wallaceowen/FilaScaleBoard/filacase.kicad_pcb

## KiCad design filacase.kicad_pcb (2021-09-25)

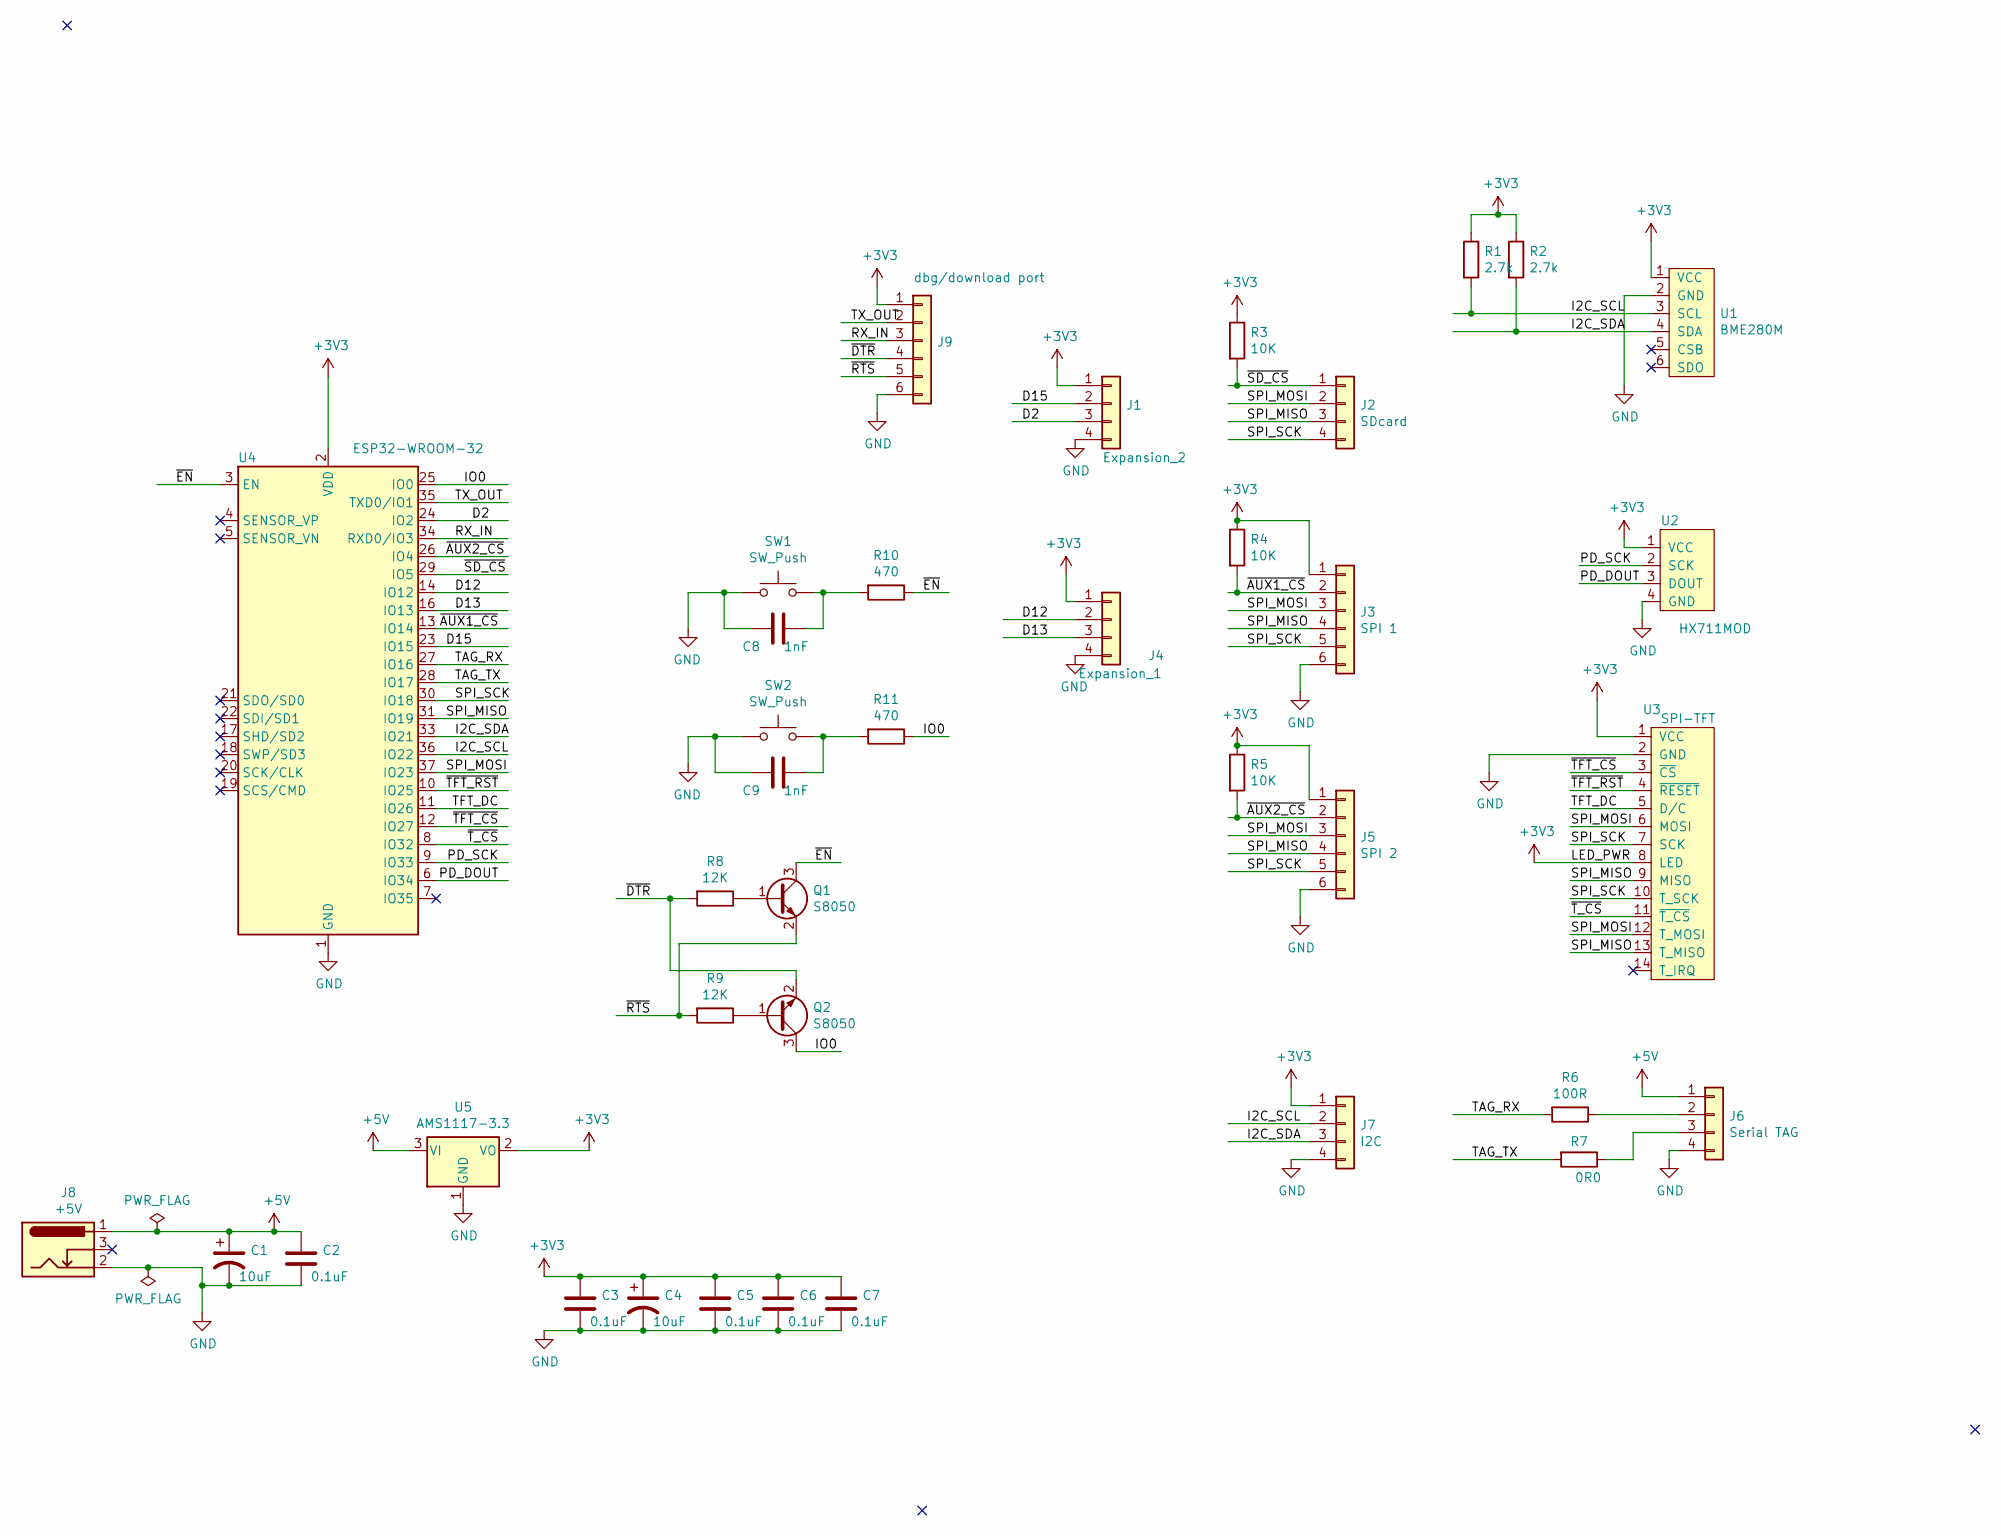
[picture p2: schematic filacase.sch]

Parts:
C1, C4: 10uF; C_2220_5650Metric_Pad1.97x5.40mm_HandSolder
C2, C3, C5, C6, C7: 0.1uF; C_0805_2012Metric
C8, C9: 1nF; C_0805_2012Metric
J1: Expansion_2; PinHeader_1x04_P2.54mm_Vertical
J2: SDcard; PinSocket_1x04_P2.54mm_Vertical
J3: SPI 1; PinHeader_1x06_P2.54mm_Vertical
J4: Expansion_1; PinHeader_1x04_P2.54mm_Vertical
J5: SPI 2; PinHeader_1x06_P2.54mm_Vertical
J6: Serial TAG; PinHeader_1x04_P2.54mm_Vertical
J7: I2C; PinHeader_1x04_P2.54mm_Vertical
J8: +5V; BarrelJack_Horizontal
J9: dbg/download port; PinHeader_1x06_P2.54mm_Vertical
Q1, Q2: S8050; SOT-23
R1, R2: 2.7k; R_0603_1608Metric
R3, R4, R5: 10K; R_0805_2012Metric
R6: 100R; R_0603_1608Metric
R7: 0R0; R_0603_1608Metric
R8, R9: 12K; R_0603_1608Metric
R10, R11: 470; R_0805_2012Metric
SW1, SW2: SW_Push; SW_Push_1P1T_NO_CK_KSC6xxJ
U1: BME280M; PinHeader_1x06_P2.54mm_Vertical
U2: HX711MOD; PinHeader_1x04_P2.54mm_Vertical
U3: SPI-TFT; PinSocket_1x14_P2.54mm_Vertical
U4: ESP32-WROOM-32
U5: AMS1117-3.3; SOT-223-3_TabPin2

Connections:
+3V3: C3.1, C4.1, C5.1, C6.1, C7.1, J1.1, J3.1, J4.1, J5.1, J7.1, J9.1, R1.1, R2.1, R3.1, R4.1, R5.1, U1.1 (VCC), U2.1 (VCC), U3.1 (VCC), U3.8 (LED), U4.2 (VDD), U5.2 (VO)
+5V: C1.1, C2.1, J6.1, J8.1, U5.3 (VI)
/D2: J1.3, U4.24 (IO2)
/D12: J4.2, U4.14 (IO12)
/D13: J4.3, U4.16 (IO13)
/D15: J1.2, U4.23 (IO15)
/I2C_SCL: J7.2, R1.2, U1.3 (SCL), U4.36 (IO22)
/I2C_SDA: J7.3, R2.2, U1.4 (SDA), U4.33 (IO21)
/IO0: Q2.3 (C), R11.1, U4.25 (IO0)
/PD_DOUT: U2.3 (DOUT), U4.6 (IO34)
/PD_SCK: U2.2 (SCK), U4.9 (IO33)
/RX_IN: J9.3, U4.34 (RXD0/IO3)
/SPI_MISO: J2.3, J3.4, J5.4, U3.9 (MISO), U3.13 (T_MISO), U4.31 (IO19)
/SPI_MOSI: J2.2, J3.3, J5.3, U3.6 (MOSI), U3.12 (T_MOSI), U4.37 (IO23)
/SPI_SCK: J2.4, J3.5, J5.5, U3.7 (SCK), U3.10 (T_SCK), U4.30 (IO18)
/TAG_RX: R6.2, U4.27 (IO16)
/TAG_TX: R7.2, U4.28 (IO17)
/TFT_DC: U3.5 (D/C), U4.11 (IO26)
/TX_OUT: J9.2, U4.35 (TXD0/IO1)
/~AUX1_CS~: J3.2, R4.2, U4.13 (IO14)
/~AUX2_CS~: J5.2, R5.2, U4.26 (IO4)
/~DTR~: J9.4, Q2.2 (E), R8.2
/~EN~: Q1.3 (C), R10.1, U4.3 (EN)
/~RTS~: J9.5, Q1.2 (E), R9.2
/~SD_CS~: J2.1, R3.2, U4.29 (IO5)
/~TFT_CS~: U3.3 (~CS~), U4.12 (IO27)
/~TFT_RST~: U3.4 (~RESET~), U4.10 (IO25)
/~T_CS~: U3.11 (~T_CS~), U4.8 (IO32)
GND: C1.2, C2.2, C3.2, C4.2, C5.2, C6.2, C7.2, C8.2, C9.2, J1.4, J3.6, J4.4, J5.6, J6.4, J7.4, J8.2, J9.6, SW1.1, SW2.1, U1.2 (GND), U2.4 (GND), U3.2 (GND), U4.1 (GND), U4.15 (GND), U4.38 (GND), U4.39 (GND), U5.1 (GND); also elsewhere on the board
unnamed: C8.1, R10.2, SW1.2
unnamed: C9.1, R11.2, SW2.2
unnamed: J6.2, R6.1
unnamed: J6.3, R7.1
unnamed: Q1.1 (B), R8.1
unnamed: Q2.1 (B), R9.1

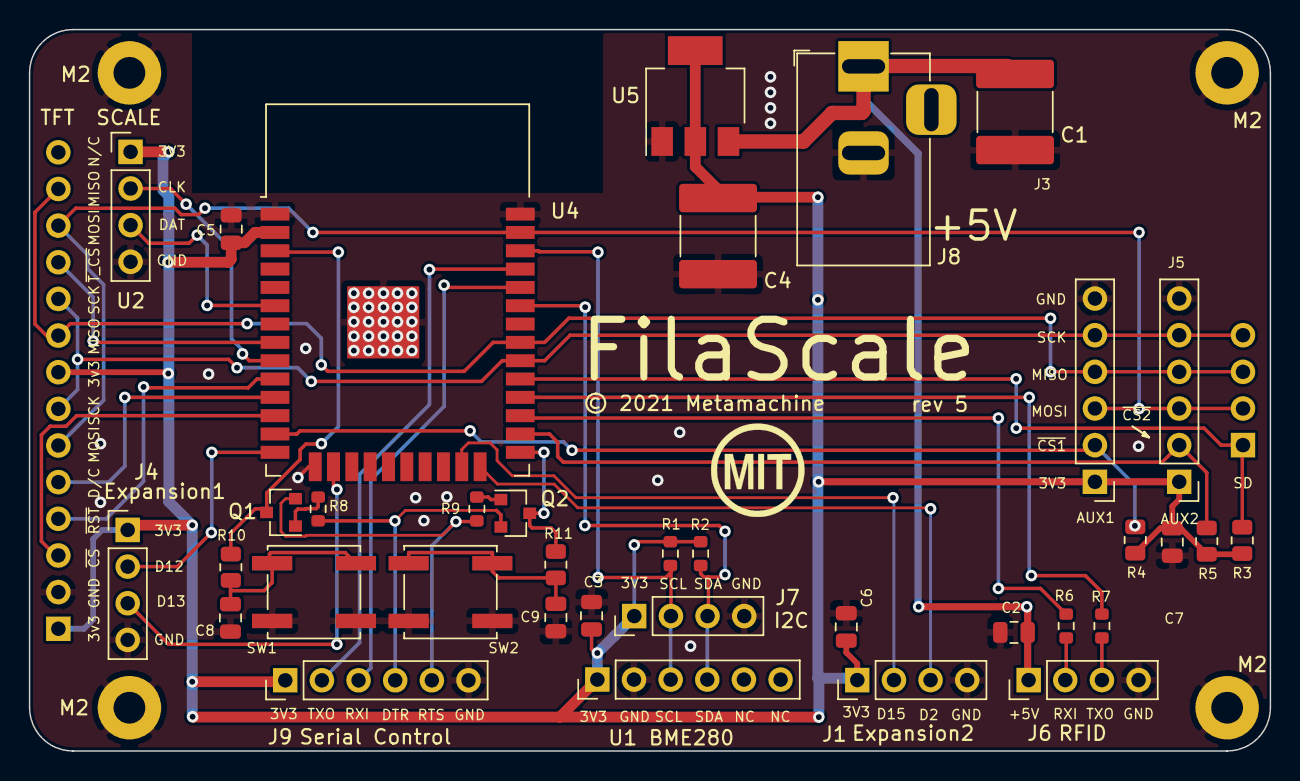
[picture p3: board filacase.kicad_pcb from above]

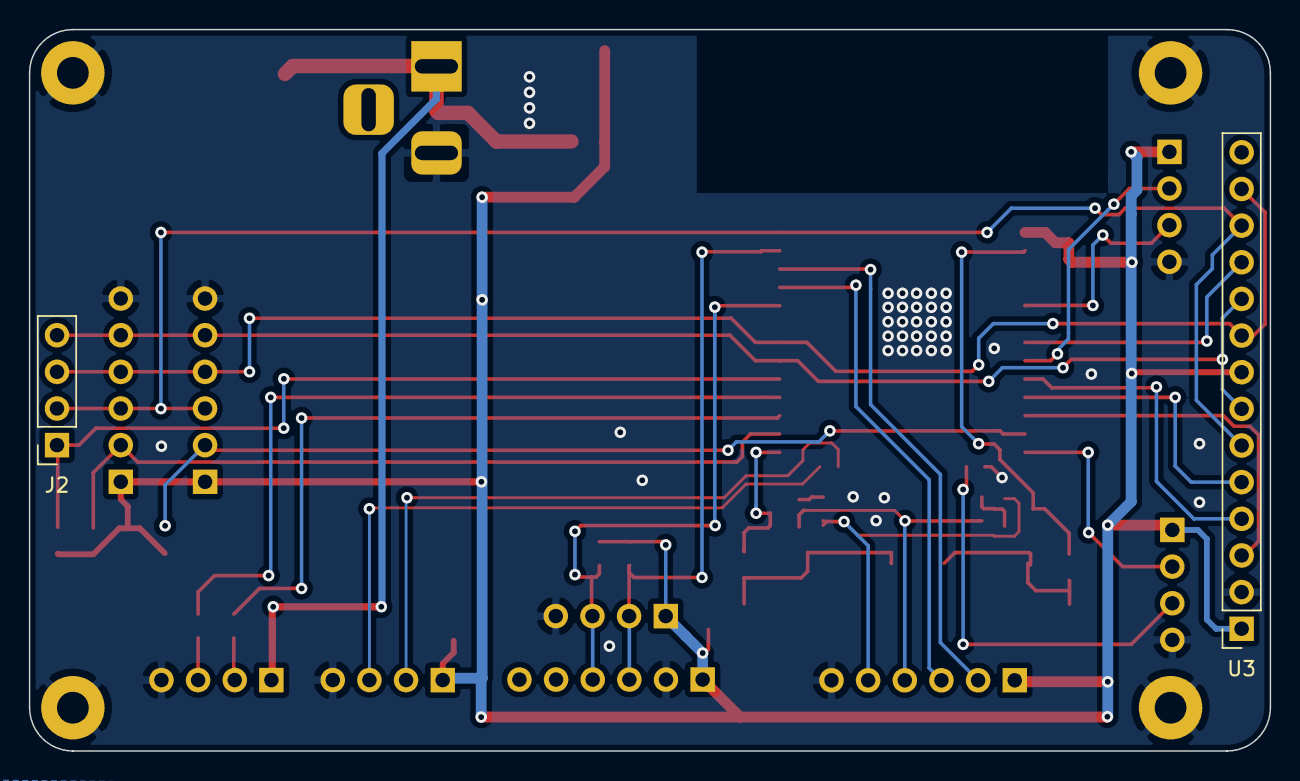
[picture p4: board filacase.kicad_pcb from below]

Board: 2 copper layers, 86.0 x 50.0 mm, 42 parts (2 on the bottom side), 35 nets.

Other parts of the board:
M2, M2#2, M2#3, M2#4: MountingHole_2.2mm_M2_Pad

Their connections:
GND: M2.1, M2#2.1, M2#3.1, M2#4.1; also elsewhere on the board
