wallaceowen/FilaScaleBoard/(commit log)

2021-09-18 FilaScaleBoard KiCAD files
    [filacase.kicad_pcb, filacase.sch]
2021-09-19 Added pic of board and
2021-09-25 Flip TFT connector around the right way
    [filacase.kicad_pcb]
2021-09-25 Tweak the layout of a couple of tracks
    [filacase.kicad_pcb]
2021-09-25 Flipped the display connector and SDCARD connector pads because flipping the connectors to the back of the board also flipped the pins up/down.
    [filacase.kicad_pcb]
2021-09-25 Generate a new render of the board; move a couple of traces and rebuild the pours
    [filacase.kicad_pcb]
