wallaceowen/FilaScaleBoard/(notices)

Notices in the files:
filacase.kicad_pcb:
© 2021 Metamachine
